wnmusic/simpleFE/hardware/simpleFE_v1.0.pdf

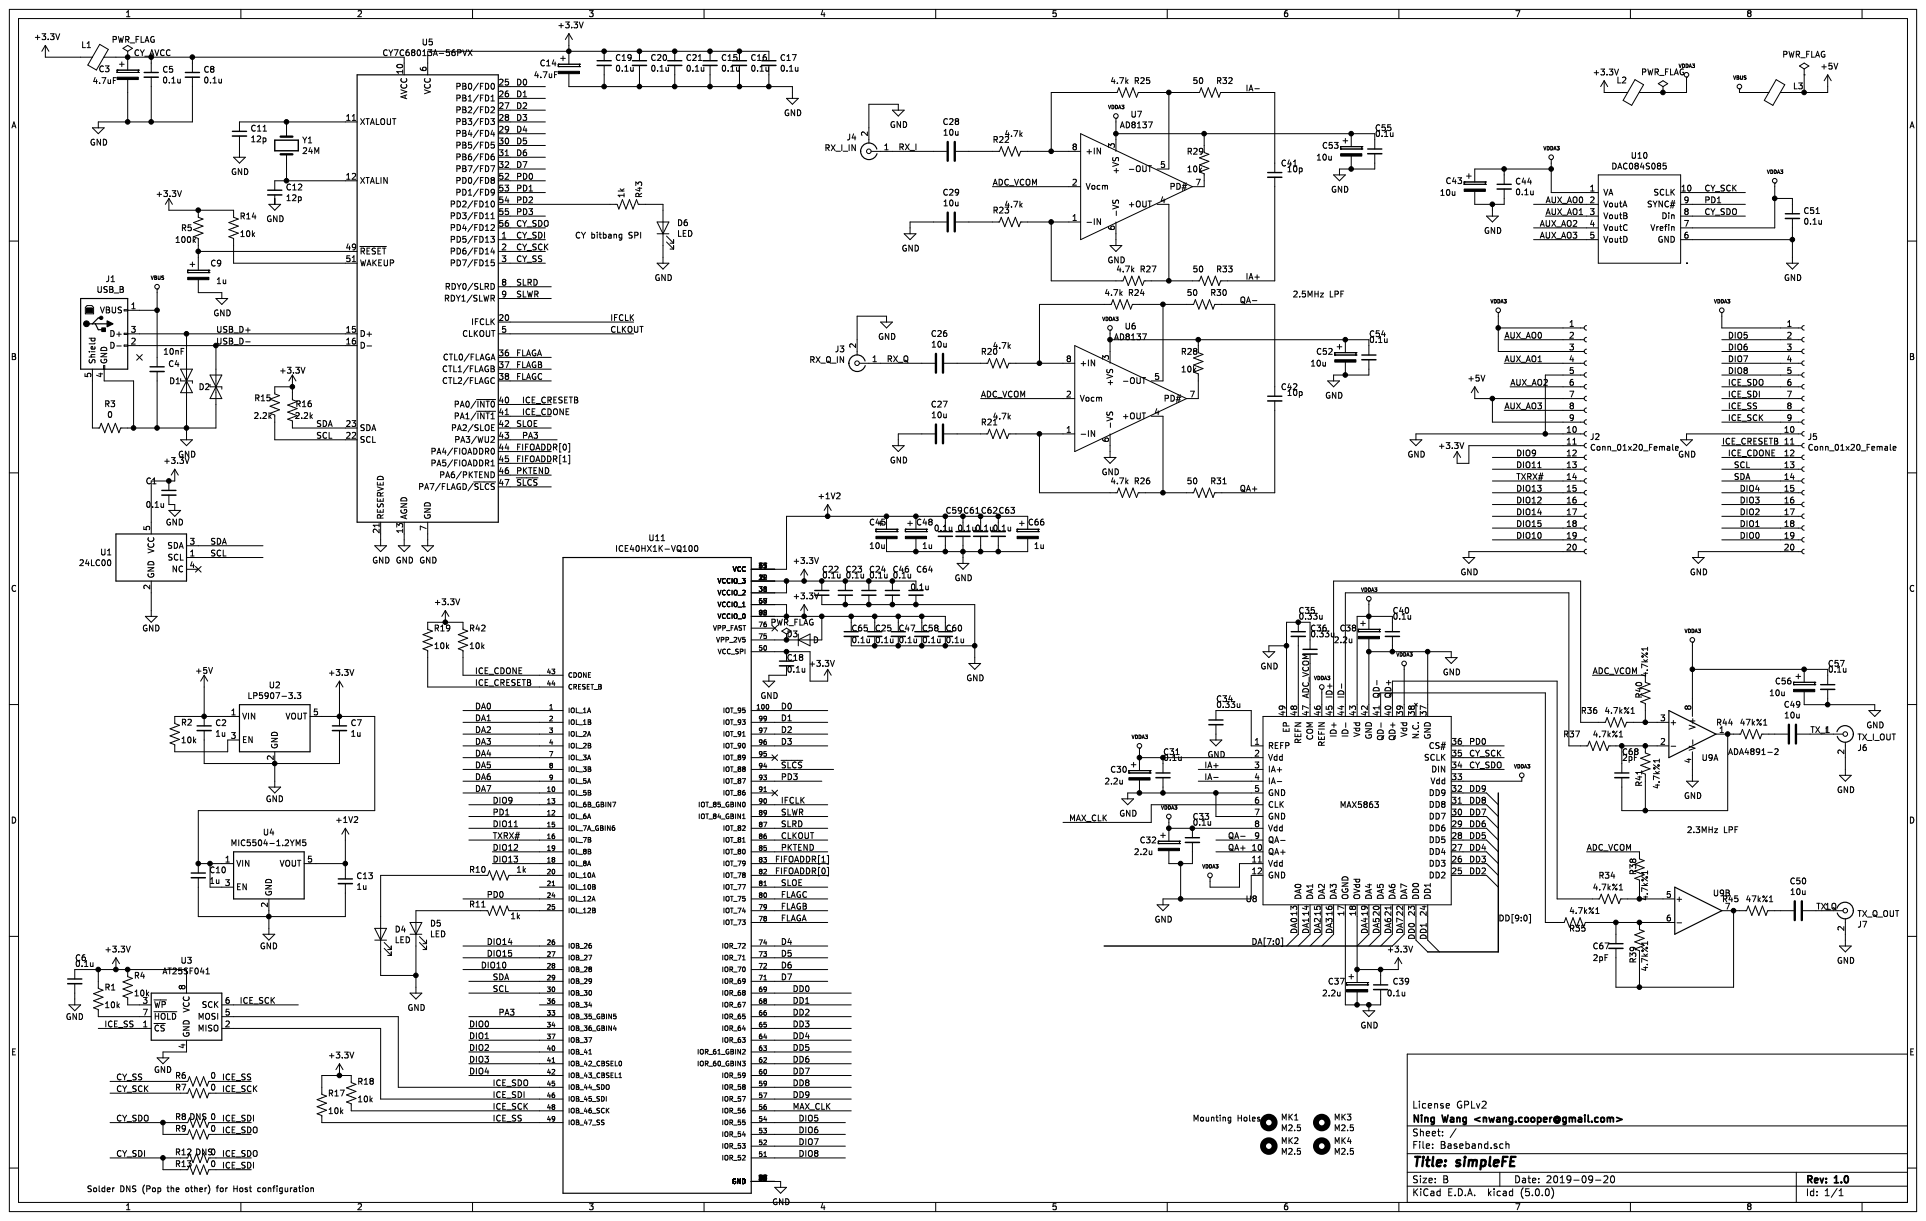
[picture p1: page 1]
