wnmusic/simpleFE/hardware/accessories/filters/filters.kicad_pcb

## KiCad design hardware/accessories/filters/filters.kicad_pcb (2019-11-18)

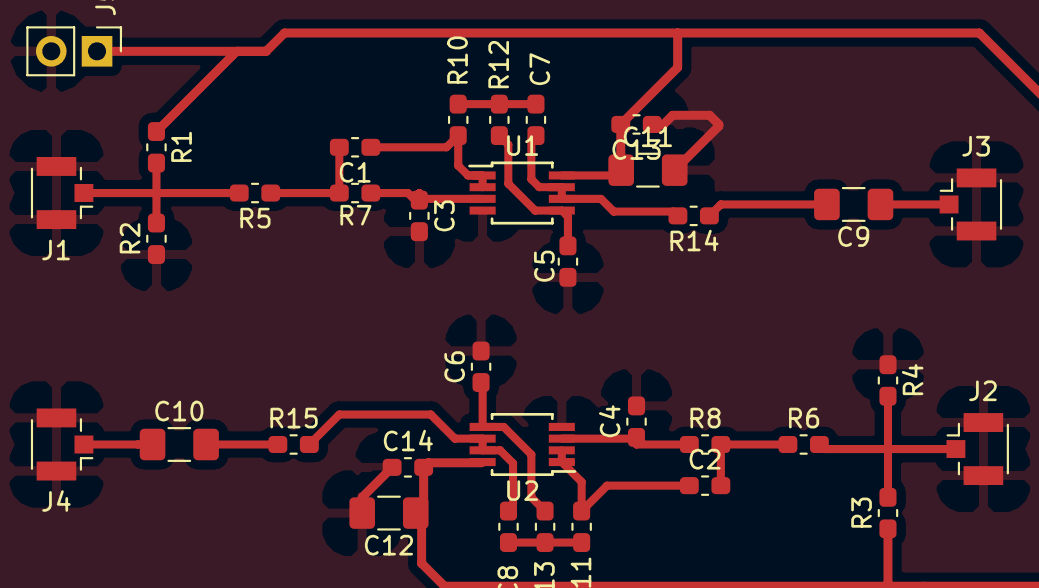
[picture p2: board filters.kicad_pcb from above]

Board: 2 copper layers, 35 parts (0 on the bottom side), 20 nets.

Parts:
C1, C2: 150p; C_0603_1608Metric_Pad1.05x0.95mm_HandSolder
C3, C4: 120p; C_0603_1608Metric_Pad1.05x0.95mm_HandSolder
C5, C6: 56p; C_0603_1608Metric_Pad1.05x0.95mm_HandSolder
C7, C8: 390p; C_0603_1608Metric_Pad1.05x0.95mm_HandSolder
C9, C10, C11, C12: 10u; C_1206_3216Metric_Pad1.42x1.75mm_HandSolder
C13, C14: 100n; C_0603_1608Metric_Pad1.05x0.95mm_HandSolder
J1, J2, J3, J4: Conn_Coaxial; U.FL_Hirose_U.FL-R-SMT-1_Vertical
J5: PWR; PinHeader_1x02_P2.54mm_Vertical
R1, R2, R3, R4: 100k; R_0603_1608Metric_Pad1.05x0.95mm_HandSolder
R5, R6: 9.1k; R_0603_1608Metric_Pad1.05x0.95mm_HandSolder
R7, R8: 15k; R_0603_1608Metric_Pad1.05x0.95mm_HandSolder
R10, R11: 9.5k; R_0603_1608Metric_Pad1.05x0.95mm_HandSolder
R12, R13: 12k; R_0603_1608Metric_Pad1.05x0.95mm_HandSolder
R14, R15: 50; R_0603_1608Metric_Pad1.05x0.95mm_HandSolder
U1, U2: ada4891-2; MSOP-8_3x3mm_P0.65mm

Connections:
GND: C3.2, C4.2, C5.2, C6.2, C11.2, C12.2, C13.1, C14.1, J1.2, J2.2, J3.2, J4.2, J5.2, R2.1, R4.1, U1.4, U2.4
unnamed: C1.1, R10.2, U1.1, U1.2
unnamed: C1.2, R5.1, R7.2
unnamed: C2.1, R11.2, U2.1, U2.2
unnamed: C2.2, R6.1, R8.2
unnamed: C3.1, R7.1, U1.3
unnamed: C4.1, R8.1, U2.3
unnamed: C5.1, R12.1, U1.5
unnamed: C6.1, R13.1, U2.5
unnamed: C7.1, R14.2, U1.6, U1.7
unnamed: C7.2, R10.1, R12.2
unnamed: C8.1, R15.2, U2.6, U2.7
unnamed: C8.2, R11.1, R13.2
unnamed: C9.1, J3.1
unnamed: C9.2, R14.1
unnamed: C10.1, J4.1
unnamed: C10.2, R15.1
unnamed: J1.1, R1.2, R2.2, R5.2
unnamed: J2.1, R3.2, R4.2, R6.2
VCC: C11.1, C12.1, C13.2, C14.2, J5.1, R1.1, R3.1, U1.8, U2.8
