wnmusic/simpleFE/hardware/Baseband.kicad_pcb

## KiCad design hardware/Baseband.kicad_pcb (2019-10-08)

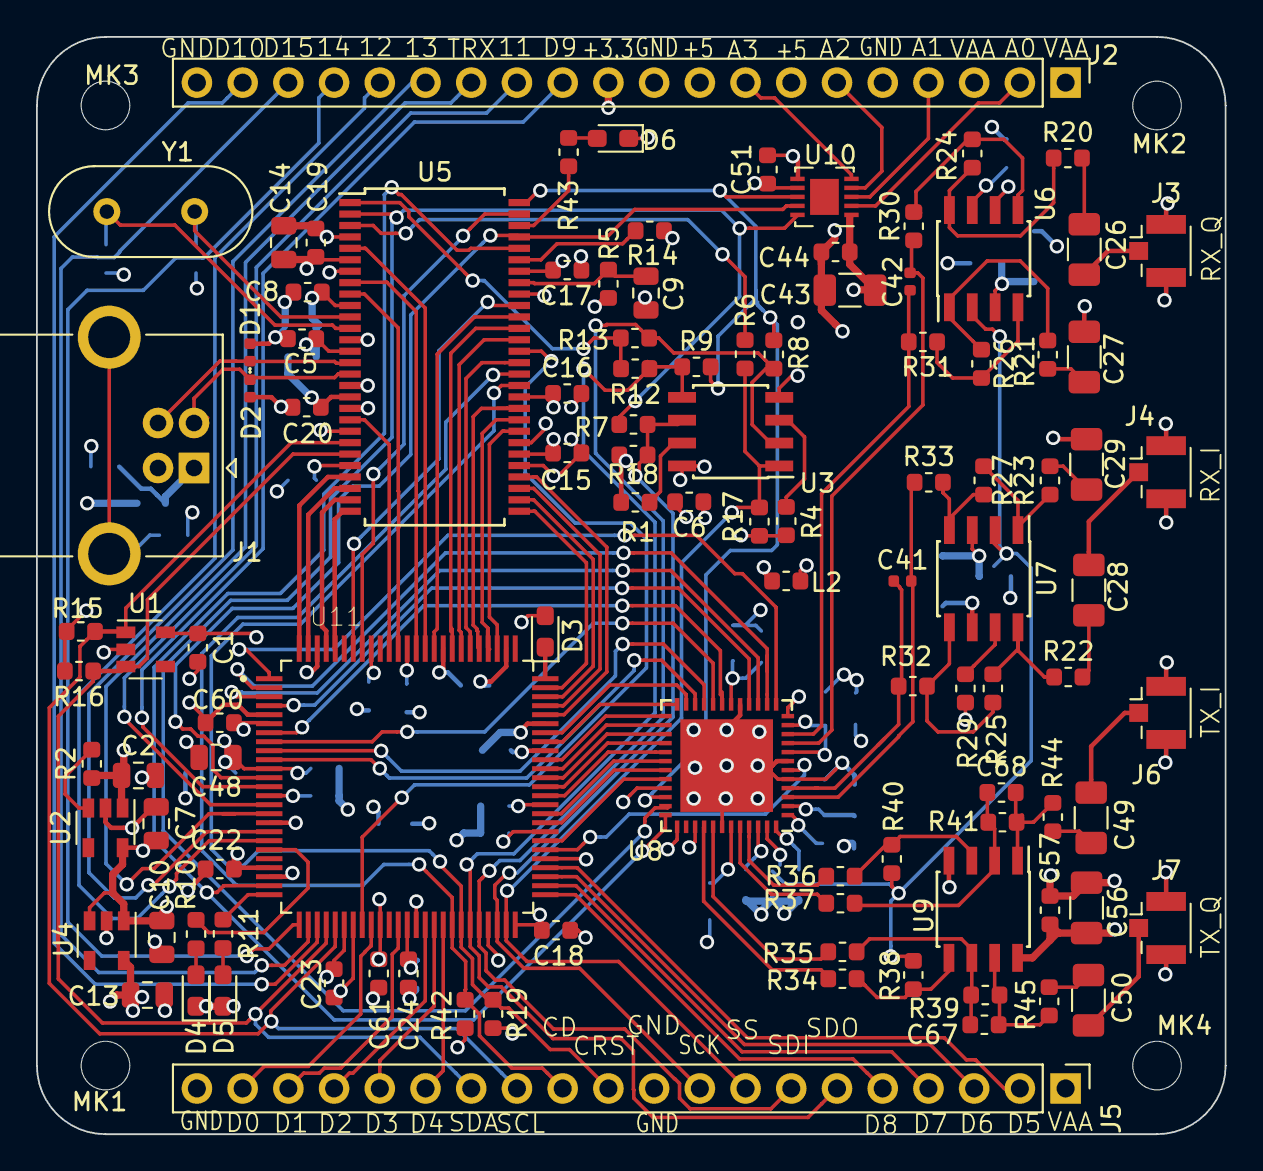
[picture p3: board Baseband.kicad_pcb from above]

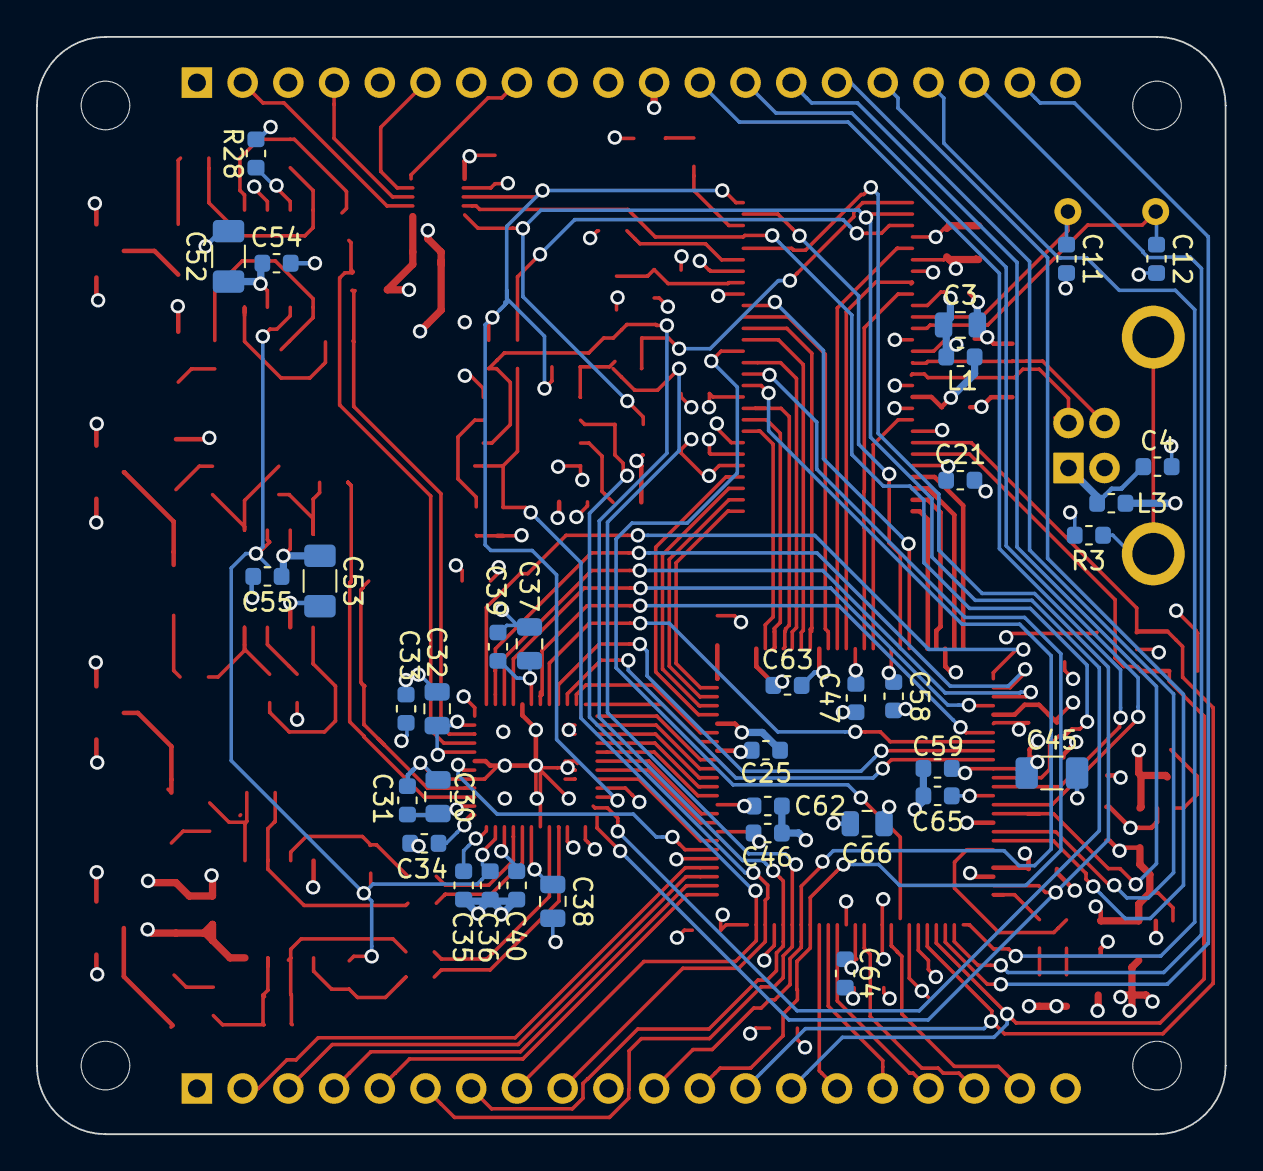
[picture p4: board Baseband.kicad_pcb from below]

Board: 4 copper layers, 66.0 x 61.0 mm, 145 parts (35 on the bottom side), 137 nets.

Parts:
C1, C5, C6, C8, C15, C16, C17, C18, C19, C20, C21, C22, C23, C24, C25, C31, C33, C39, C40, C44, C46, C47, C51, C54, C55, C57, C58, C59, C60, C61, C62, C63, C64, C65: 0.1u; C_0603_1608Metric
C2, C7, C9, C10, C13, C48, C66: 1u; C_0805_2012Metric
C3, C14: 4.7uF; C_0805_2012Metric
C4: 10nF; C_0603_1608Metric
C11, C12: 12p; C_0603_1608Metric
C26, C27, C28, C29, C43, C45, C49, C50, C52, C53, C56: 10u; C_1206_3216Metric
C30, C32, C37, C38: 2.2u; C_0805_2012Metric
C34, C35, C36: 0.33u; C_0603_1608Metric
C41, C42: 10p; C_0402_1005Metric
C67, C68: 2pF; C_0603_1608Metric
D1, D2: D_TVS; D_0402_1005Metric
D3: D; D_0603_1608Metric_Pad1.05x0.95mm_HandSolder
D4, D5, D6: LED; LED_0603_1608Metric_Pad1.05x0.95mm_HandSolder
J1: USB_B; USB_B_OST_USB-B1HSxx_Horizontal
J2, J5: Conn_01x20_Female; PinHeader_1x20_P2.54mm_Vertical
J3: RX_Q_IN; U.FL_Hirose_U.FL-R-SMT-1_Vertical
J4: RX_I_IN; U.FL_Hirose_U.FL-R-SMT-1_Vertical
J6: TX_I_OUT; U.FL_Hirose_U.FL-R-SMT-1_Vertical
J7: TX_Q_OUT; U.FL_Hirose_U.FL-R-SMT-1_Vertical
L1, L2, L3: BLM18KG601BH1D; L_0603_1608Metric
MK1, MK2, MK3, MK4: M2.5; MountingHole_2.7mm_M2.5
R1, R2, R4, R14, R17, R18, R19, R28, R29, R42: 10k; R_0603_1608Metric
R3, R6, R7, R8, R9, R12, R13: 0; R_0603_1608Metric
R5: 100k; R_0603_1608Metric
R10, R11, R43: 1k; R_0603_1608Metric
R15, R16: 2.2k; R_0603_1608Metric
R20, R21, R22, R23, R24, R25, R26, R27: 4.7k; R_0603_1608Metric
R30, R31, R32, R33: 50; R_0603_1608Metric
R34, R35, R36, R37, R38, R39, R40, R41: 4.7k%1; R_0603_1608Metric
R44, R45: 47k%1; R_0603_1608Metric
U1: 24LC00; SOT-23-5
U2: LP5907-3.3; SOT-23-5
U3: AT25SF041; SOIC-8_3.9x4.9mm_P1.27mm
U4: MIC5504-1.2YM5; SOT-23-5
U5: CY7C68013A-56PVX; SSOP-56_7.5x18.5mm_P0.635mm
U6, U7: AD8137; SOIC-8_3.9x4.9mm_P1.27mm
U8: MAX5863; QFN-48-1EP_7x7mm_P0.5mm_EP5.15x5.15mm
U9: ADA4891-2; SOIC-8_3.9x4.9mm_P1.27mm
U10: DAC084S085; Texas_DSC0010A
U11: ICE40HX1K-VQ100; QFP50P1600X1600X120-100N
Y1: 24M; Crystal_HC49-U_Vertical

Connections:
+1V2: C13.1, C45.1, C48.1, C59.1, C61.1, C62.1, C63.1, C66.1, U4.5, U11.11, U11.35, U11.61, U11.77
+3V3: C1.1, C6.1, C7.1, C10.1, C14.1, C15.1, C16.1, C17.1, C18.1, C19.1, C20.1, C21.1, C22.1, C23.1, C24.1, C25.1, C37.1, C39.1, C46.1, C47.1, C58.1, C60.1, C64.1, C65.1, D3.2, J2.11, L1.1, L2.1, R1.1, R4.1, R5.1, R14.1, R15.2, R16.2, R17.1, R18.1, R19.1, R42.1, U1.5, U2.5, U3.8, U4.1, U4.3, U5.6, U5.18, U5.24, U5.34, U5.39, U5.50, U8.18, U11.6, U11.14, U11.22, U11.31, U11.38, U11.50, U11.58, U11.67, U11.88, U11.92
+5V: C2.1, J2.7, J2.9, L3.2, R2.1, U2.1
/ADC_VCOM: C36.2, R38.2, R40.2, U6.2, U7.2, U8.47
/AUX_AO0: J2.2, U10.2
/AUX_AO1: J2.4, U10.3
/AUX_AO2: J2.6, U10.4
/AUX_AO3: J2.8, U10.5
/CLKOUT: U5.5, U11.86
/CY_AVCC: C3.1, C5.1, C8.1, L1.2, U5.10, U5.14
/CY_SCK: R7.2, U5.2, U8.35, U10.10
/CY_SDI: R12.2, R13.2, U5.1
/CY_SDO: R8.2, R9.2, U5.56, U8.34, U10.8
/CY_SS: R6.2, U5.3
/D0: U5.25, U11.100
/D1: U5.26, U11.99
/D2: U5.27, U11.97
/D3: U5.28, U11.96
/D4: U5.29, U11.74
/D5: U5.30, U11.73
/D6: U5.31, U11.72
/D7: U5.32, U11.71
/DA0: U8.13, U11.1
/DA1: U8.14, U11.2
/DA2: U8.15, U11.3
/DA3: U8.16, U11.4
/DA4: U8.19, U11.7
/DA5: U8.20, U11.8
/DA6: U8.21, U11.9
/DA7: U8.22, U11.10
/DD0: U8.23, U11.69
/DD1: U8.24, U11.68
/DD2: U8.25, U11.66
/DD3: U8.26, U11.65
/DD4: U8.27, U11.64
/DD5: U8.28, U11.63
/DD6: U8.29, U11.62
/DD7: U8.30, U11.60
/DD8: U8.31, U11.59
/DD9: U8.32, U11.57
/DIO0: J5.19, U11.34
/DIO1: J5.18, U11.37
/DIO2: J5.17, U11.40
/DIO3: J5.16, U11.41
/DIO4: J5.15, U11.42
/DIO5: J5.2, U11.54
/DIO6: J5.3, U11.53
/DIO7: J5.4, U11.52
/DIO8: J5.5, U11.51
/DIO9: J2.12, U11.13
/DIO10: J2.19, U11.28
/DIO11: J2.13, U11.15
/DIO12: J2.16, U11.19
/DIO13: J2.15, U11.18
/DIO14: J2.17, U11.26
/DIO15: J2.18, U11.27
/FIFOADDR[0]: U5.44, U11.82
/FIFOADDR[1]: U5.45, U11.83
/FLAGA: U5.36, U11.78
/FLAGB: U5.37, U11.79
/FLAGC: U5.38, U11.80
/IA+: C41.2, R33.1, U8.3
/IA-: C41.1, R32.1, U8.4
/ICE_CDONE: J5.12, R42.2, U5.41, U11.43
/ICE_CRESETB: J5.11, R19.2, U5.40, U11.44
/ICE_SCK: J5.9, R7.1, R18.2, U3.6, U11.48
/ICE_SDI: J5.7, R8.1, R13.1, U3.2, U11.46
/ICE_SDO: J5.6, R9.1, R12.1, U3.5, U11.45
/ICE_SS: J5.8, R6.1, R17.2, U3.1, U11.49
/ID+: R36.2, U8.45
/ID-: R37.2, U8.44
/IFCLK: U5.20, U11.90
/MAX_CLK: U8.6, U11.56
/PA3: U5.43, U11.33
/PD0: U5.52, U8.36, U11.24
/PD1: U5.53, U10.9, U11.12
/PD2: R43.2, U5.54
/PD3: U5.55, U11.93
/PKTEND: U5.46, U11.85
/QA+: C42.2, R31.1, U8.10
/QA-: C42.1, R30.1, U8.9
/QD+: R34.2, U8.40
/QD-: R35.2, U8.41
/RX_I: C28.2, J4.1
/RX_Q: C26.2, J3.1
/SCL: J5.13, R15.1, U1.1, U5.22, U11.30
/SDA: J5.14, R16.1, U1.3, U5.23, U11.29
/SLOE: U5.42, U11.81
/SLRD: U5.8, U11.87
/SLWR: U5.9, U11.89
/TXRX#: J2.14, U11.16
/TX_I: C49.1, J6.1
/TX_Q: C50.1, J7.1
/USB_D+: D1.1, J1.3, U5.15
/USB_D-: D2.1, J1.2, U5.16
/~SLCS: U5.47, U11.94
GND: C1.2, C2.2, C3.2, C4.2, C5.2, C6.2, C7.2, C8.2, C9.2, C10.2, C11.2, C12.2, C13.2, C14.2, C15.2, C16.2, C17.2, C18.2, C19.2, C20.2, C21.2, C22.2, C23.2, C24.2, C25.2, C27.2, C29.2, C30.2, C31.2, C32.2, C33.2, C34.2, C35.1, C36.1, C37.2, C38.2, C39.2, C40.2, C43.2, C44.2, C45.2, C46.2, C47.2, C48.2, C51.2, C52.2, C53.2, C54.2, C55.2, C56.2, C57.2, C58.2, C59.2, C60.2, C61.2, C62.2, C63.2, C64.2, C65.2, C66.2, D1.2, D2.2, D4.1, D5.1, D6.1, J1.4, J2.5, J2.10, J2.20, J3.2, J4.2, J5.10, J5.20, J6.2, J7.2, R3.1, U1.2, U2.2, U3.4, U4.2, U5.4, U5.7, U5.13, U5.17, U5.19, U5.21, U5.33, U5.35, U5.48, U6.6, U7.6, U8.5, U8.7, U8.12, U8.17, U8.37, U8.42, U8.49, U9.4, U10.6, U11.5, U11.17, U11.23, U11.32, U11.39, U11.47, U11.55, U11.70, U11.84, U11.98
unnamed: C9.1, R5.2, U5.49
unnamed: C11.1, U5.11, Y1.1
unnamed: C12.1, U5.12, Y1.2
unnamed: C26.1, R20.2
unnamed: C27.1, R21.2
unnamed: C28.1, R22.2
unnamed: C29.1, R23.2
unnamed: C34.1, U8.1
unnamed: C35.2, U8.48
unnamed: C49.2, R44.1
unnamed: C50.2, R45.1
unnamed: C67.1, R35.1, R39.2, U9.6
unnamed: C67.2, R39.1, R45.2, U9.7
unnamed: C68.1, R37.1, R41.2, U9.2
unnamed: C68.2, R41.1, R44.2, U9.1
unnamed: D3.1, U11.75
unnamed: D4.2, R10.2
unnamed: D5.2, R11.2
unnamed: D6.2, R43.1
unnamed: J1.5, R3.2
unnamed: R1.2, U3.7
unnamed: R2.2, U2.3
unnamed: R4.2, U3.3
unnamed: R10.1, U11.20
unnamed: R11.1, U11.25
unnamed: R14.2, U5.51
unnamed: R20.1, R24.2, U6.8
unnamed: R21.1, R26.2, U6.1
unnamed: R22.1, R25.2, U7.8
unnamed: R23.1, R27.2, U7.1
unnamed: R24.1, R30.2, U6.5
unnamed: R25.1, R32.2, U7.5
unnamed: R26.1, R31.2, U6.4
unnamed: R27.1, R33.2, U7.4
unnamed: R28.2, U6.7
unnamed: R29.2, U7.7
unnamed: R34.1, R38.1, U9.5
unnamed: R36.1, R40.1, U9.3
VBUS: C4.1, J1.1, L3.1
VDDA3: C30.1, C31.1, C32.1, C33.1, C38.1, C40.1, C43.1, C44.1, C51.1, C52.1, C53.1, C54.1, C55.1, C56.1, C57.1, J2.1, J2.3, J5.1, L2.2, R28.1, R29.1, U6.3, U7.3, U8.2, U8.8, U8.11, U8.33, U8.39, U8.43, U8.46, U9.8, U10.1, U10.7
