wnmusic/simpleFE/(commit log)

2019-10-08 add hardware source files
    [Baseband.kicad_pcb, Baseband.sch]
2019-10-21 add a filter design
    [filters.kicad_pcb, filters.sch]
2019-10-31 get filter pcb
    [filters.kicad_pcb, filters.sch]
2019-11-03 update the filter sch
    [filters.sch]
2019-11-04 add a test RC filter
2019-11-19 should make the last sample right
2020-02-19 adding i2c support
2020-04-12 add external spi example
2020-04-14 fix bugs on i2c and use i2c for gpio
    [external_spi.c, loopback.c, simpleFE.c]
