wnmusic/simpleFE/(notices)

Notices in the files:
libsimpleFE/ezusb.c:
General Public License as published by the Free Software
hardware/HDL/fifo.v:
Copyright (C) 2000-2002 Rudolf Usselmann
hardware/Baseband.sch:
License GPLv2
hardware/accessories/filters/filters.sch:
2019, All rights reserved
